3-kat/arbiter4-fixed-priority/docs/images/01_device_generator_probe.png

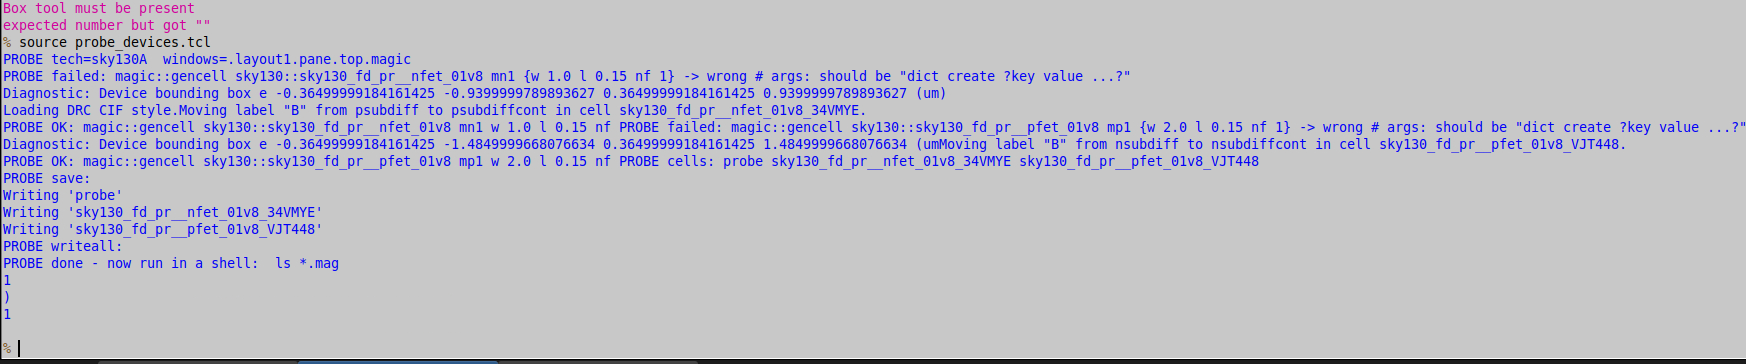
docs/images/01_device_generator_probe.png
