3-kat/arbiter4-fixed-priority/docs/images/03_drc_min_area_message.png

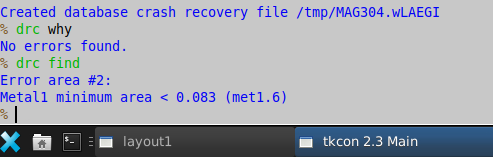
docs/images/03_drc_min_area_message.png
