3-kat/arbiter4-fixed-priority/docs/images/03b_via1_overlap_error.png

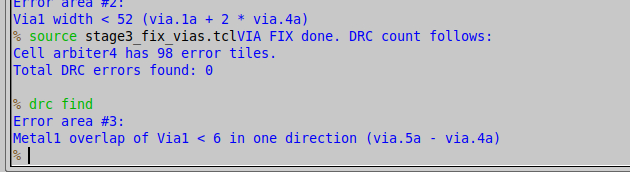
docs/images/03b_via1_overlap_error.png
