3-kat/arbiter4-fixed-priority/docs/images/02_first_placement_before_fixes.png

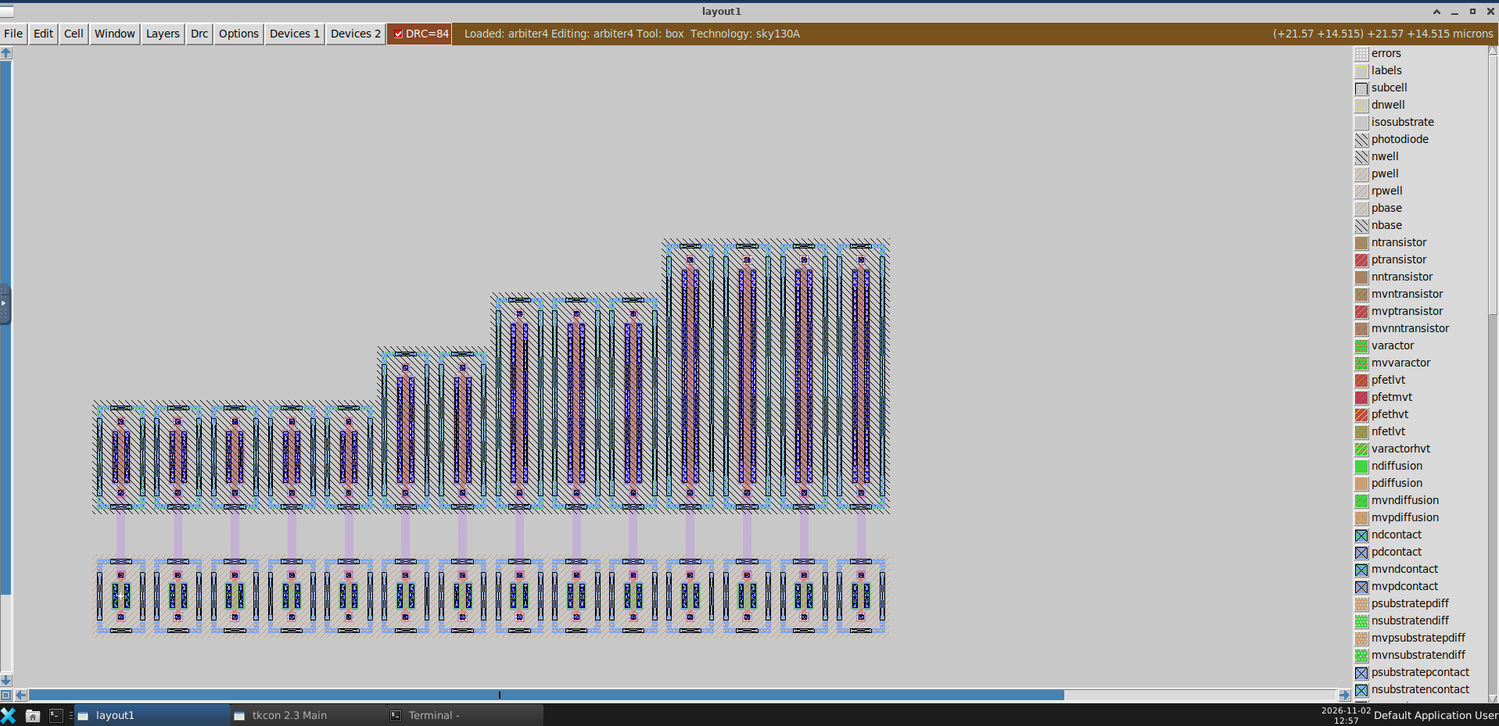
docs/images/02_first_placement_before_fixes.png
